eightdotz/esp32-wavplayer/src/final/README.md

Display driver changed from SSD1306 to SSD1315 and uses the ESP32-C3 chip.
