eightdotz/esp32-wavplayer/kicad_pcb_model/final/schematic.pdf

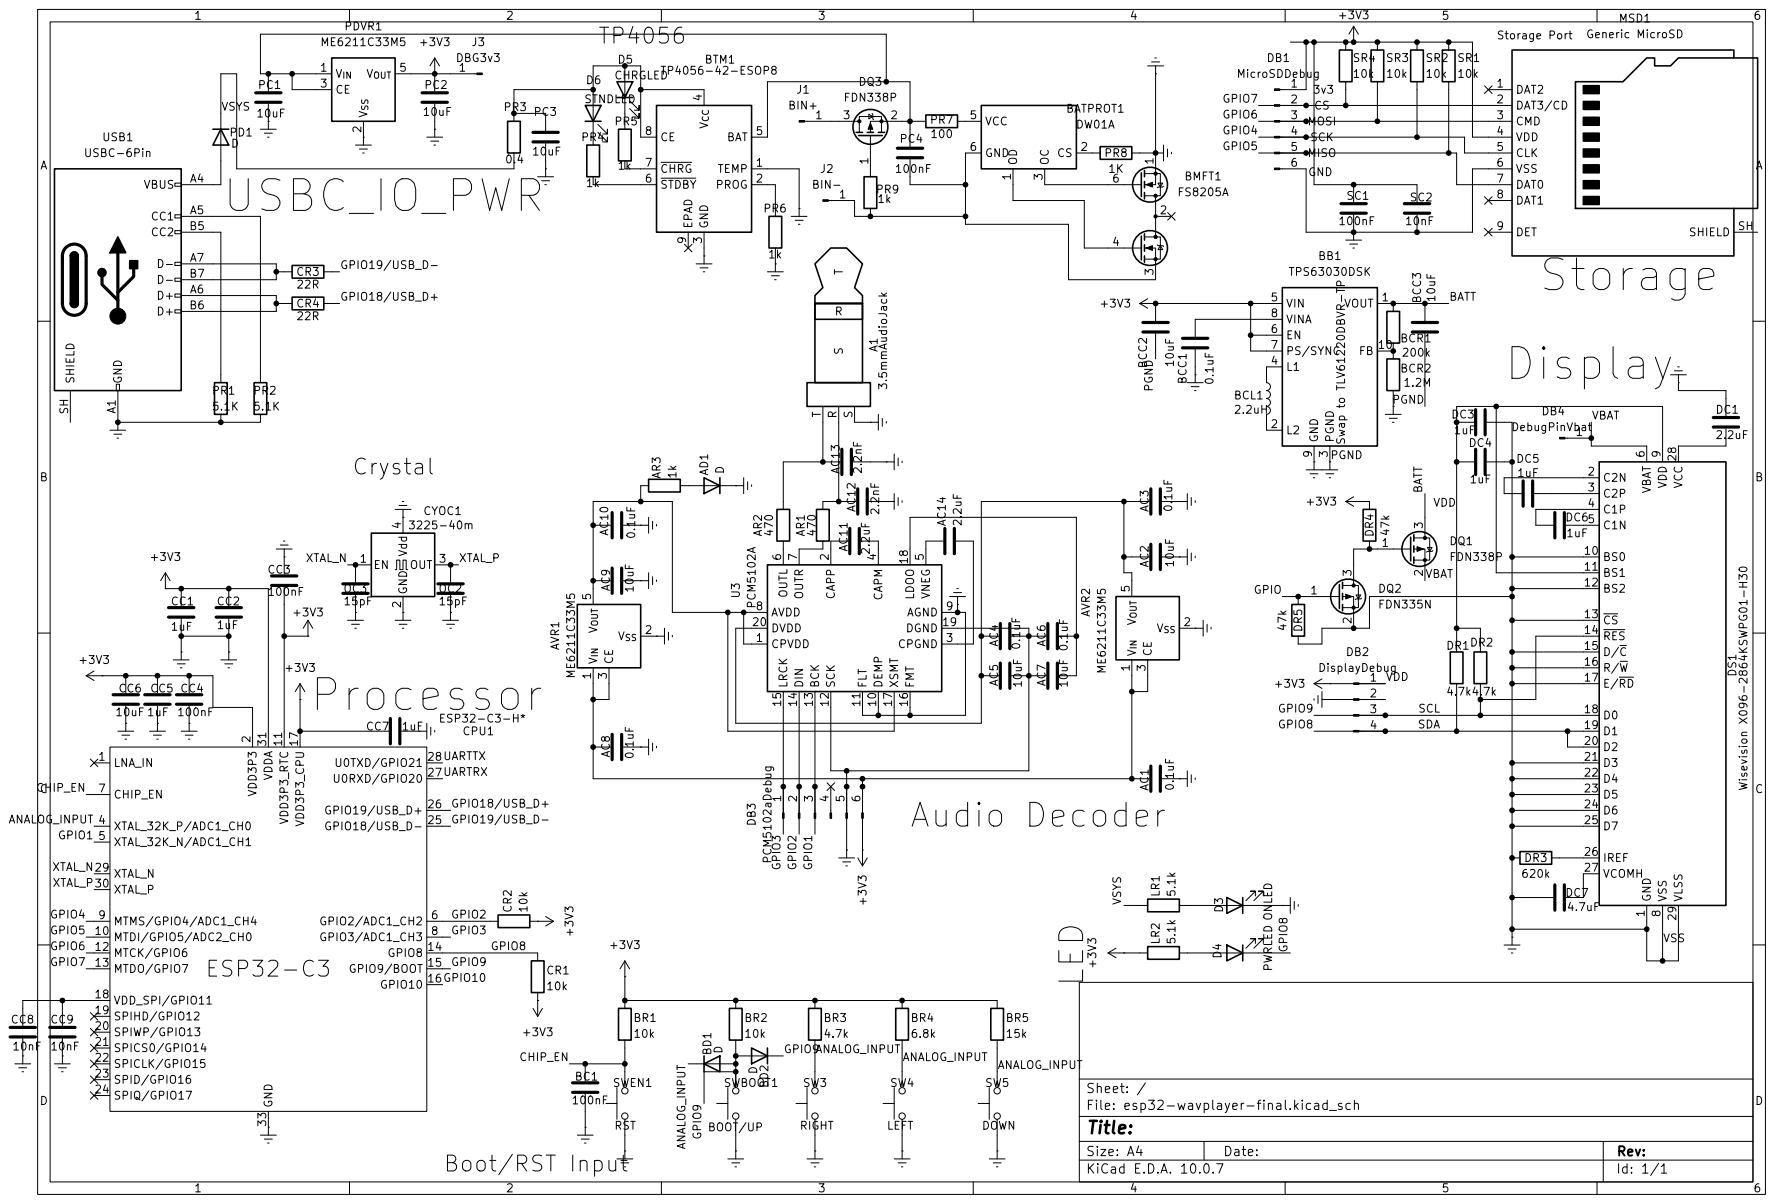
[picture p1: page 1]
