eightdotz/esp32-wavplayer/kicad_pcb_model/final/esp32-wavplayer-final.kicad_pcb

## KiCad design kicad_pcb_model/final/esp32-wavplayer-final.kicad_pcb (2026-11-09)

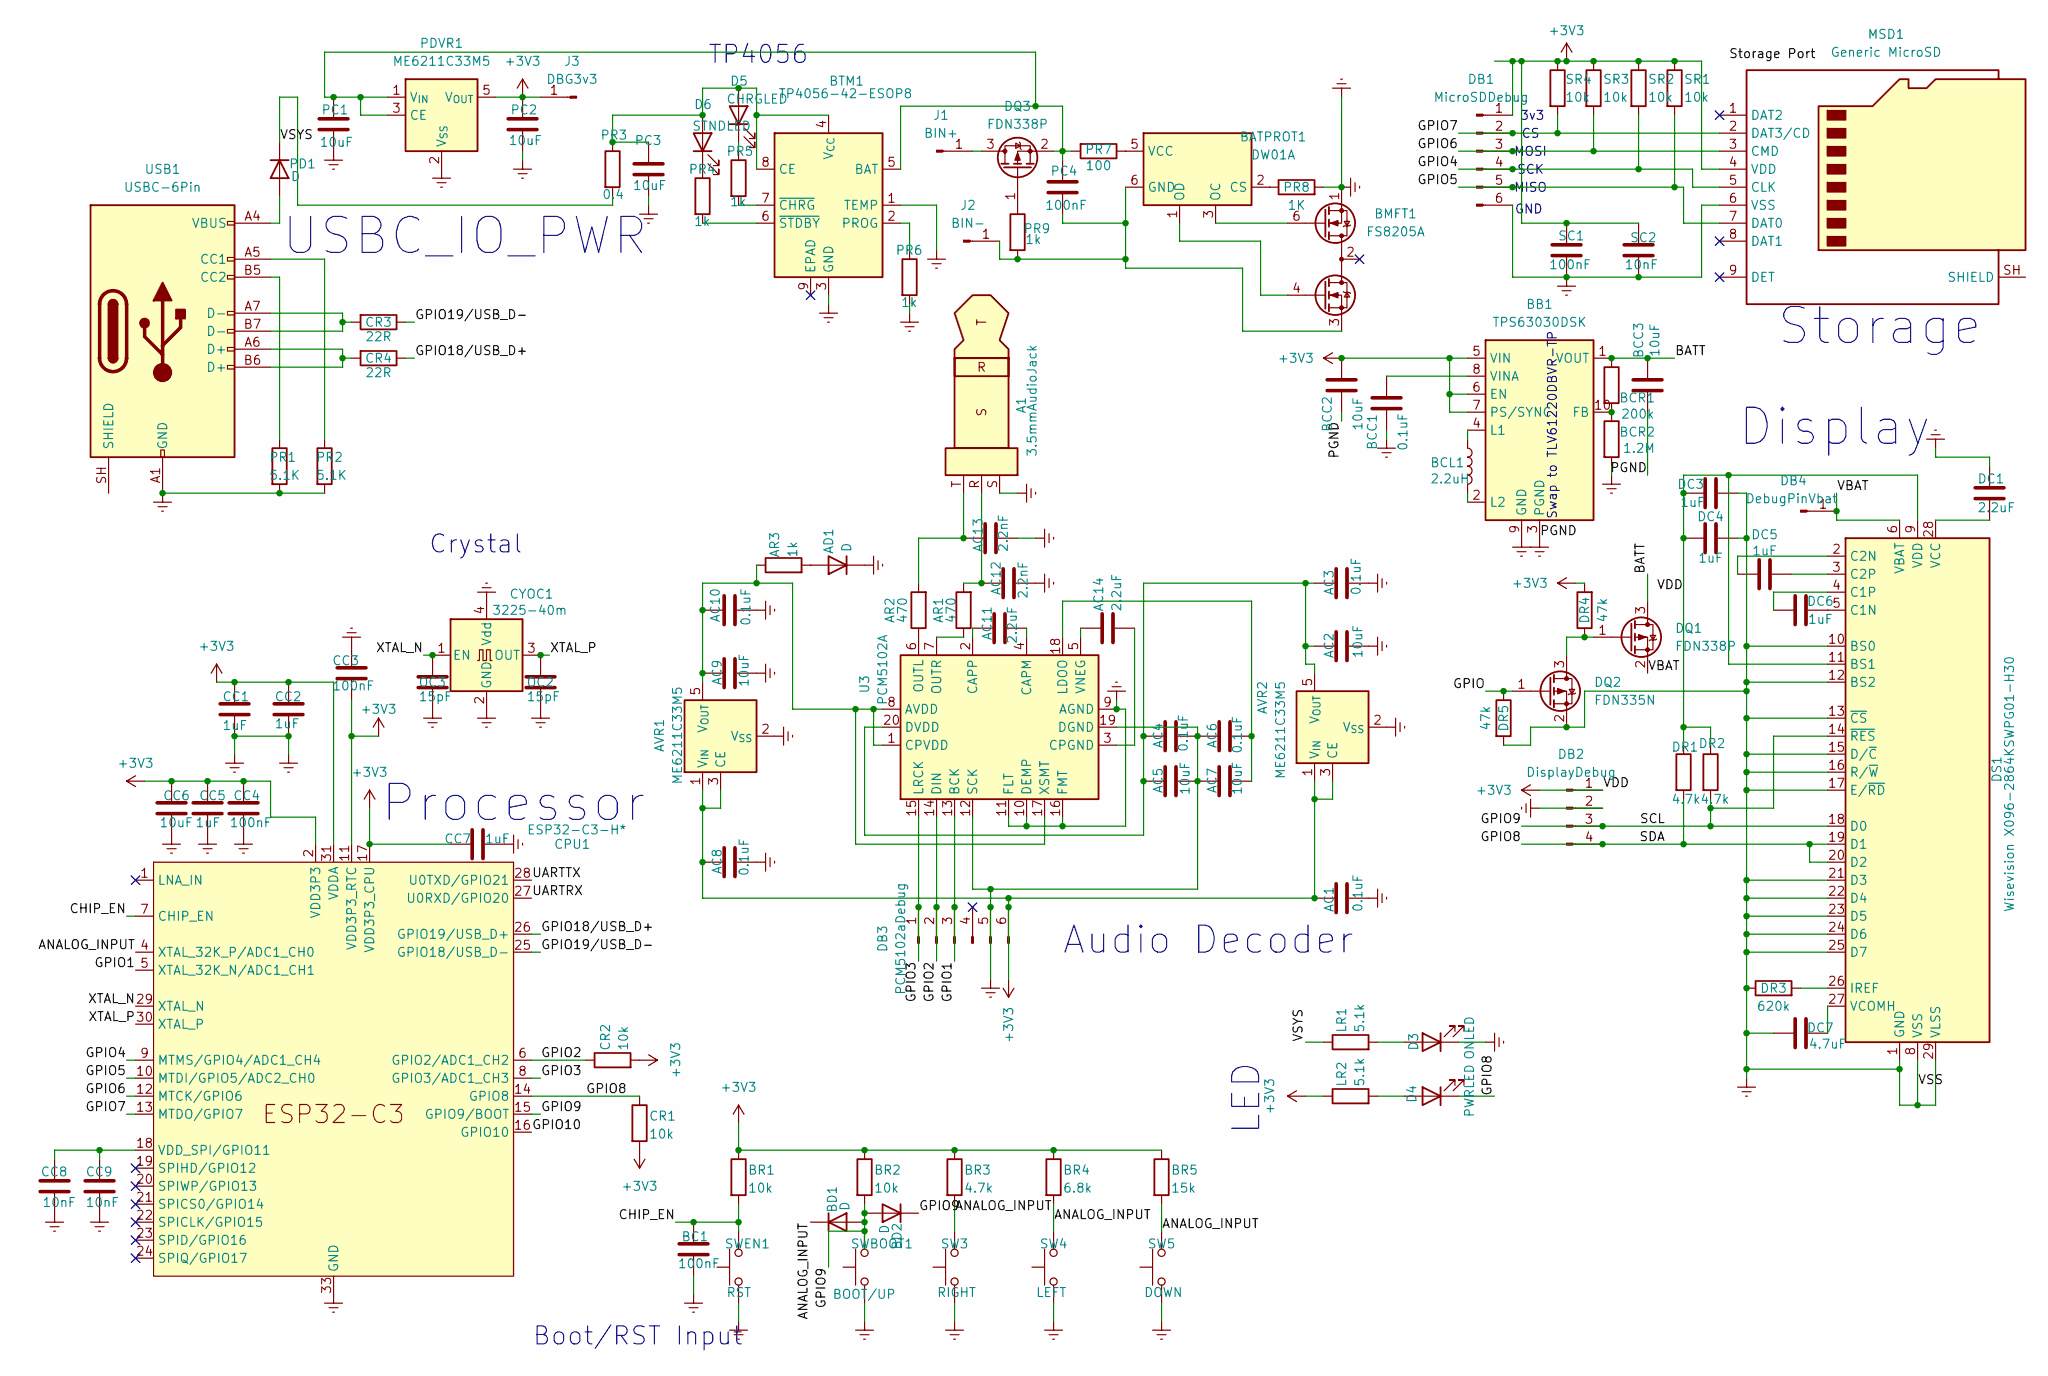
[picture p2: schematic esp32-wavplayer-final.kicad_sch]

Parts:
A1: 3.5mmAudioJack; Jack_3.5mm_KoreanHropartsElec_PJ-320D-4A_Horizontal
AC1, AC3, AC4, AC6, AC8, AC10: 0.1uF; C_0603_1608Metric_Pad1.08x0.95mm_HandSolder
AC2, AC5, AC7, AC9: 10uF; C_0603_1608Metric_Pad1.08x0.95mm_HandSolder
AC11, AC14: 2.2uF; C_0603_1608Metric_Pad1.08x0.95mm_HandSolder
AC12, AC13: 2.2nF; C_0603_1608Metric_Pad1.08x0.95mm_HandSolder
AD1: D; D_0603_1608Metric_Pad1.05x0.95mm_HandSolder
AR1, AR2: 470; R_0603_1608Metric_Pad0.98x0.95mm_HandSolder
AR3: 1k; R_0603_1608Metric_Pad0.98x0.95mm_HandSolder
AVR1, AVR2: ME6211C33M5; SOT-23-5
BATPROT1: DW01A; SOT-23-6
BB1: TPS63030DSK; WSON-10-1EP_2.5x2.5mm_P0.5mm_EP1.2x2mm
BC1: 100nF; C_0603_1608Metric_Pad1.08x0.95mm_HandSolder
BCC1: 0.1uF; C_0603_1608Metric_Pad1.08x0.95mm_HandSolder
BCC2, BCC3: 10uF; C_0603_1608Metric_Pad1.08x0.95mm_HandSolder
BCL1: 2.2uH; L_0201_0603Metric_Pad0.64x0.40mm_HandSolder
BCR1: 200k; R_0603_1608Metric_Pad0.98x0.95mm_HandSolder
BCR2: 1.2M; R_0603_1608Metric_Pad0.98x0.95mm_HandSolder
BD1, BD2: D; D_0603_1608Metric_Pad1.05x0.95mm_HandSolder
BMFT1: FS8205A; SOT-23-6
BR1, BR2: 10k; R_0603_1608Metric_Pad0.98x0.95mm_HandSolder
BR3: 4.7k; R_0603_1608Metric_Pad0.98x0.95mm_HandSolder
BR4: 6.8k; R_0603_1608Metric_Pad0.98x0.95mm_HandSolder
BR5: 15k; R_0603_1608Metric_Pad0.98x0.95mm_HandSolder
BTM1: TP4056-42-ESOP8; SOIC-8_3.9x4.9mm_P1.27mm
CC1, CC2, CC5, CC7: 1uF; C_0603_1608Metric_Pad1.08x0.95mm_HandSolder
CC3, CC4: 100nF; C_0603_1608Metric_Pad1.08x0.95mm_HandSolder
CC6: 10uF; C_0603_1608Metric_Pad1.08x0.95mm_HandSolder
CC8, CC9: 10nF; C_0603_1608Metric_Pad1.08x0.95mm_HandSolder
CPU1: ESP32-C3-H*; QFN-32-1EP_5x5mm_P0.5mm_EP3.45x3.45mm
CR1, CR2: 10k; R_0603_1608Metric_Pad0.98x0.95mm_HandSolder
CR3, CR4: 22R; R_0603_1608Metric_Pad0.98x0.95mm_HandSolder
CYOC1: 3225-40m; Oscillator_SMD_Abracon_ASE-4Pin_3.2x2.5mm
D3: PWRLED; LED_0603_1608Metric_Pad1.05x0.95mm_HandSolder
D4: ONLED; LED_0603_1608Metric_Pad1.05x0.95mm_HandSolder
D5: CHRGLED; LED_0603_1608Metric_Pad1.05x0.95mm_HandSolder
D6: STNDLED; LED_0603_1608Metric_Pad1.05x0.95mm_HandSolder
DB1: MicroSDDebug; PinHeader_1x06_P2.54mm_Vertical
DB2: DisplayDebug; PinHeader_1x04_P2.54mm_Vertical
DB3: PCM5102aDebug; PinHeader_1x06_P2.54mm_Vertical
DB4: DebugPinVbat; PinHeader_1x01_P2.54mm_Vertical
DC1: 2.2uF; C_0603_1608Metric_Pad1.08x0.95mm_HandSolder
DC3, DC4, DC5, DC6: 1uF; C_0603_1608Metric_Pad1.08x0.95mm_HandSolder
DC7: 4.7uF; C_0603_1608Metric_Pad1.08x0.95mm_HandSolder
DQ1, DQ3: FDN338P; SOT-23
DQ2: FDN335N; SOT-23
DR1, DR2: 4.7k; R_0603_1608Metric_Pad0.98x0.95mm_HandSolder
DR3: 620k; R_0603_1608Metric_Pad0.98x0.95mm_HandSolder
DR4, DR5: 47k; R_0603_1608Metric_Pad0.98x0.95mm_HandSolder
DS1: Wisevision X096-2864KSWPG01-H30; OLED-128O064D
J1: BIN+; PinHeader_1x01_P2.54mm_Vertical
J2: BIN-; PinHeader_1x01_P2.54mm_Vertical
J3: DBG3v3; PinHeader_1x01_P2.54mm_Vertical
LR1, LR2: 5.1k; R_0603_1608Metric_Pad0.98x0.95mm_HandSolder
MSD1: Generic MicroSD; microSD_HC_Hirose_DM3AT-SF-PEJM5
OC2, OC3: 15pF; C_0603_1608Metric_Pad1.08x0.95mm_HandSolder
PC1, PC2, PC3: 10uF; C_0603_1608Metric_Pad1.08x0.95mm_HandSolder
PC4: 100nF; C_0603_1608Metric_Pad1.08x0.95mm_HandSolder
PD1: D; D_0603_1608Metric_Pad1.05x0.95mm_HandSolder
PDVR1: ME6211C33M5; SOT-23-5
PR1, PR2: 5.1K; R_0603_1608Metric_Pad0.98x0.95mm_HandSolder
PR3: 0.4; R_0603_1608Metric_Pad0.98x0.95mm_HandSolder
PR4, PR5, PR6, PR9: 1k; R_0603_1608Metric_Pad0.98x0.95mm_HandSolder
PR7: 100; R_0603_1608Metric_Pad0.98x0.95mm_HandSolder
PR8: 1K; R_0603_1608Metric_Pad0.98x0.95mm_HandSolder
SC1: 100nF; C_0603_1608Metric_Pad1.08x0.95mm_HandSolder
SC2: 10nF; C_0603_1608Metric_Pad1.08x0.95mm_HandSolder
SR1, SR2, SR3, SR4: 10k; R_0603_1608Metric_Pad0.98x0.95mm_HandSolder
SW3: RIGHT; SW_SPST_TS-1088-xR020
SW4: LEFT; SW_SPST_TS-1088-xR020
SW5: DOWN; SW_SPST_TS-1088-xR020
SWBOOT1: BOOT/UP; SW_SPST_TS-1088-xR020
SWEN1: RST; SW_SPST_TS-1088-xR020
U3: PCM5102A; TSSOP-20_4.4x6.5mm_P0.65mm
USB1: USBC-6Pin; USB_C_Receptacle_HRO_TYPE-C-31-M-12

Connections:
+3V3: AC1.1, AC8.1, AVR1.1 (V_{IN}), AVR1.3 (CE), AVR2.1 (V_{IN}), AVR2.3 (CE), BB1.5 (VIN), BB1.6 (EN), BB1.7 (PS/SYNC), BCC2.2, BR1.1, BR2.1, BR3.1, BR4.1, BR5.1, CC1.1, CC2.1, CC3.2, CC4.1, CC5.1, CC6.1, CC7.1, CPU1.2 (VDD3P3), CPU1.3 (VDD3P3), CPU1.11 (VDD3P3_RTC), CPU1.17 (VDD3P3_CPU), CPU1.31 (VDDA), CPU1.32 (VDDA), CR1.2, CR2.2, DB1.1, DB2.1, DB3.6, DC3.1, DC4.2, DR1.1, DR2.1, DR4.2, DS1.9 (VDD), DS1.11 (BS1), J3.1 (Pin_1_1), LR2.1, MSD1.4 (VDD), PC2.1, PDVR1.5 (V_{OUT}), SC1.1, SC2.1, SR1.1, SR2.1, SR3.1, SR4.1
/ANALOG_INPUT: BD1.1 (K), BR3.2, BR4.2, BR5.2, CPU1.4 (XTAL_32K_P/ADC1_CH0), SW3.2, SW4.2, SW5.2
/BATT: BB1.1 (VOUT), BCC3.2, BCR1.1, DQ1.3 (D)
/CHIP_EN: BC1.1, BR1.2, CPU1.7 (CHIP_EN), SWEN1.2
/GPIO: DQ2.1 (G), DR5.1
/GPIO1: CPU1.5 (XTAL_32K_N/ADC1_CH1), DB3.3, U3.13 (BCK)
/GPIO2: CPU1.6 (GPIO2/ADC1_CH2), CR2.1, DB3.2, U3.14 (DIN)
/GPIO3: CPU1.8 (GPIO3/ADC1_CH3), DB3.1, U3.15 (LRCK)
/GPIO4: CPU1.9 (MTMS/GPIO4/ADC1_CH4), DB1.4, MSD1.5 (CLK), SR2.2
/GPIO5: CPU1.10 (MTDI/GPIO5/ADC2_CH0), DB1.5, MSD1.7 (DAT0), SR1.2
/GPIO6: CPU1.12 (MTCK/GPIO6), DB1.3, MSD1.3 (CMD), SR3.2
/GPIO7: CPU1.13 (MTDO/GPIO7), DB1.2, MSD1.2 (DAT3/CD), SR4.2
/GPIO8: CPU1.14 (GPIO8), CR1.1, D4.1 (K), DB2.4, DR1.2, DS1.19 (D1), DS1.20 (D2)
/GPIO9: BD1.2 (A), BD2.1 (K), BD2.2 (A), BR2.2, CPU1.15 (GPIO9/BOOT), DB2.3, DR2.2, DS1.14 (~RES), DS1.18 (D0), SWBOOT1.2
/GPIO10: CPU1.16 (GPIO10)
/GPIO18/USB_D+: CPU1.26 (GPIO19/USB_D+), CR4.1
/GPIO19/USB_D-: CPU1.25 (GPIO18/USB_D-), CR3.1
/UARTRX: CPU1.27 (U0RXD/GPIO20)
/UARTTX: CPU1.28 (U0TXD/GPIO21)
/VBAT: DB4.1 (Pin_1_1), DQ1.2 (S), DS1.6 (VBAT)
/VSYS: LR1.1, PD1.1 (K), PR3.2
/XTAL_N: CPU1.29 (XTAL_N), CYOC1.1 (EN), OC3.1
/XTAL_P: CPU1.30 (XTAL_P), CYOC1.3 (OUT), OC2.1
Earth: A1.S, AC1.2, AC2.2, AC3.2, AC4.2, AC5.2, AC6.1, AC7.1, AC8.2, AC9.2, AC10.2, AC12.2, AC13.2, AD1.1 (K), AVR1.2 (V_{SS}), AVR2.2 (V_{SS}), BB1.3 (PGND), BB1.9 (GND), BB1.11 (PGND), BC1.2, BCC1.1, BCC2.1, BCC3.1, BCR2.2, BMFT1.1 (D1), BTM1.1 (TEMP), BTM1.3 (GND), CC1.2, CC2.2, CC3.1, CC4.2, CC5.2, CC6.2, CC7.2, CC8.2, CC9.2, CPU1.33 (GND), CYOC1.2 (GND), CYOC1.4 (Vdd), D3.1 (K), DB1.6, DB2.2, DB3.5, DC1.1, DC3.2, DC4.1, DC7.1, DQ2.2 (S), DR3.1, DR5.2, DS1.1 (GND), DS1.8 (VSS), DS1.10 (BS0), DS1.12 (BS2), DS1.13 (~CS), DS1.15 (D/~C), DS1.16 (R/~W), DS1.17 (E/~RD), DS1.21 (D3), DS1.22 (D4), DS1.23 (D5), DS1.24 (D6), DS1.25 (D7), DS1.29 (VLSS), DS1.30 (GND), MSD1.6 (VSS), OC2.2, OC3.2, PC1.2, PC2.2, PC3.2, PDVR1.2 (V_{SS}), PR1.2, PR2.2, PR6.2, PR8.2, SC1.2, SC2.2, SW3.1, SW4.1, SW5.1, SWBOOT1.1, SWEN1.1, U3.9 (AGND), U3.10 (DEMP), U3.11 (FLT), U3.12 (SCK), U3.16 (FMT), U3.19 (DGND), USB1.A1 (GND), USB1.A12 (GND), USB1.B1 (GND), USB1.B12 (GND)
unnamed: A1.R, AC12.1, AR1.2
unnamed: A1.T, AC13.1, AR2.2
unnamed: AD1.2 (A), AR3.2
unnamed: AC9.1, AC10.1, AR3.1, AVR1.5 (V_{OUT}), U3.1 (CPVDD), U3.8 (AVDD), U3.17 (XSMT)
unnamed: AC2.1, AC3.1, AC4.1, AC5.1, AVR2.5 (V_{OUT}), U3.20 (DVDD)
unnamed: BATPROT1.2 (CS), PR8.1
unnamed 30: BATPROT1.6 (GND), BMFT1.3 (S2), J2.1, PC4.2, PR9.2; also elsewhere on the board
unnamed: BATPROT1.3 (OC), BMFT1.6 (G1)
unnamed: BATPROT1.1 (OD), BMFT1.4 (G2)
unnamed: BATPROT1.5 (VCC), PR7.1
unnamed: BB1.10 (FB), BCR1.2, BCR2.1
unnamed: BB1.4 (L1), BCL1.1
unnamed: BB1.2 (L2), BCL1.2
unnamed: BB1.8 (VINA), BCC1.2
unnamed: BTM1.5 (BAT), DQ3.2 (S), PC1.1, PC4.1, PDVR1.1 (V_{IN}), PDVR1.3 (CE), PR7.2
unnamed: BTM1.4 (V_{CC}), BTM1.8 (CE), D5.2 (A), D6.2 (A), PC3.1, PR3.1
unnamed: BTM1.2 (PROG), PR6.1
unnamed: BTM1.7 (~CHRG), PR5.2
unnamed: BTM1.6 (~STDBY), PR4.2
unnamed: CC8.1, CC9.1, CPU1.18 (VDD_SPI/GPIO11)
unnamed: CR3.2, USB1.A7 (D-), USB1.B7 (D-)
unnamed: CR4.2, USB1.A6 (D+), USB1.B6 (D+)
unnamed: D3.2 (A), LR1.2
unnamed: D4.2 (A), LR2.2
unnamed: D5.1 (K), PR5.1
unnamed: D6.1 (K), PR4.1
unnamed: DQ1.1 (G), DQ2.3 (D), DR4.1
unnamed: DQ3.3 (D), J1.1 (Pin_1_1)
unnamed: DQ3.1 (G), PR9.1
unnamed: DC6.2, DS1.5 (C1N)
unnamed: DC6.1, DS1.4 (C1P)
unnamed: DC5.1, DS1.2 (C2N)
unnamed: DC5.2, DS1.3 (C2P)
unnamed: DR3.2, DS1.26 (IREF)
unnamed: DC1.2, DS1.28 (VCC)
unnamed: DC7.2, DS1.27 (VCOMH)
unnamed: PD1.2 (A), USB1.A4 (VBUS), USB1.A9 (VBUS), USB1.B4 (VBUS), USB1.B9 (VBUS)
unnamed: AC11.2, U3.4 (CAPM)
unnamed: AC11.1, U3.2 (CAPP)
unnamed: AC14.2, U3.3 (CPGND)
unnamed: AC6.2, AC7.2, U3.18 (LDOO)
unnamed: AR2.1, U3.6 (OUTL)
unnamed: AR1.1, U3.7 (OUTR)
unnamed: AC14.1, U3.5 (VNEG)
unnamed: PR2.1, USB1.A5 (CC1)
unnamed: PR1.1, USB1.B5 (CC2)

Notes on the sheet:
Display
Storage
Audio Decoder
MOSI
MISO
Crystal
LED
SCK
Processor
USBC_IO_PWR
3v3
GND
TP4056
Boot/RST Input
Swap to TLV61220DBVR-TP

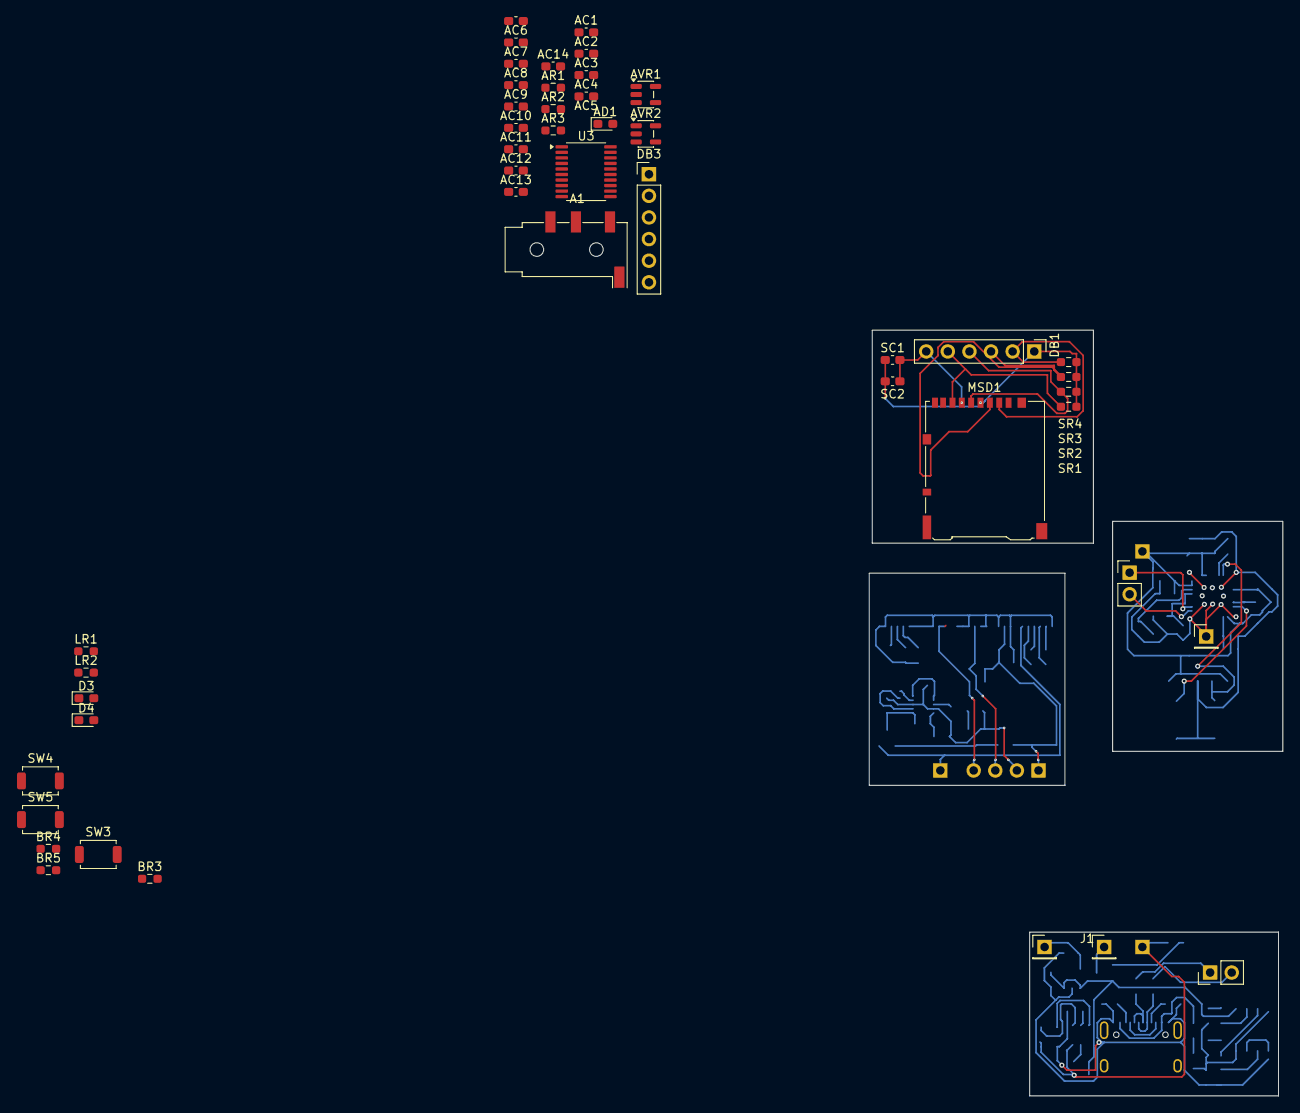
[picture p3: board esp32-wavplayer-final.kicad_pcb from above]

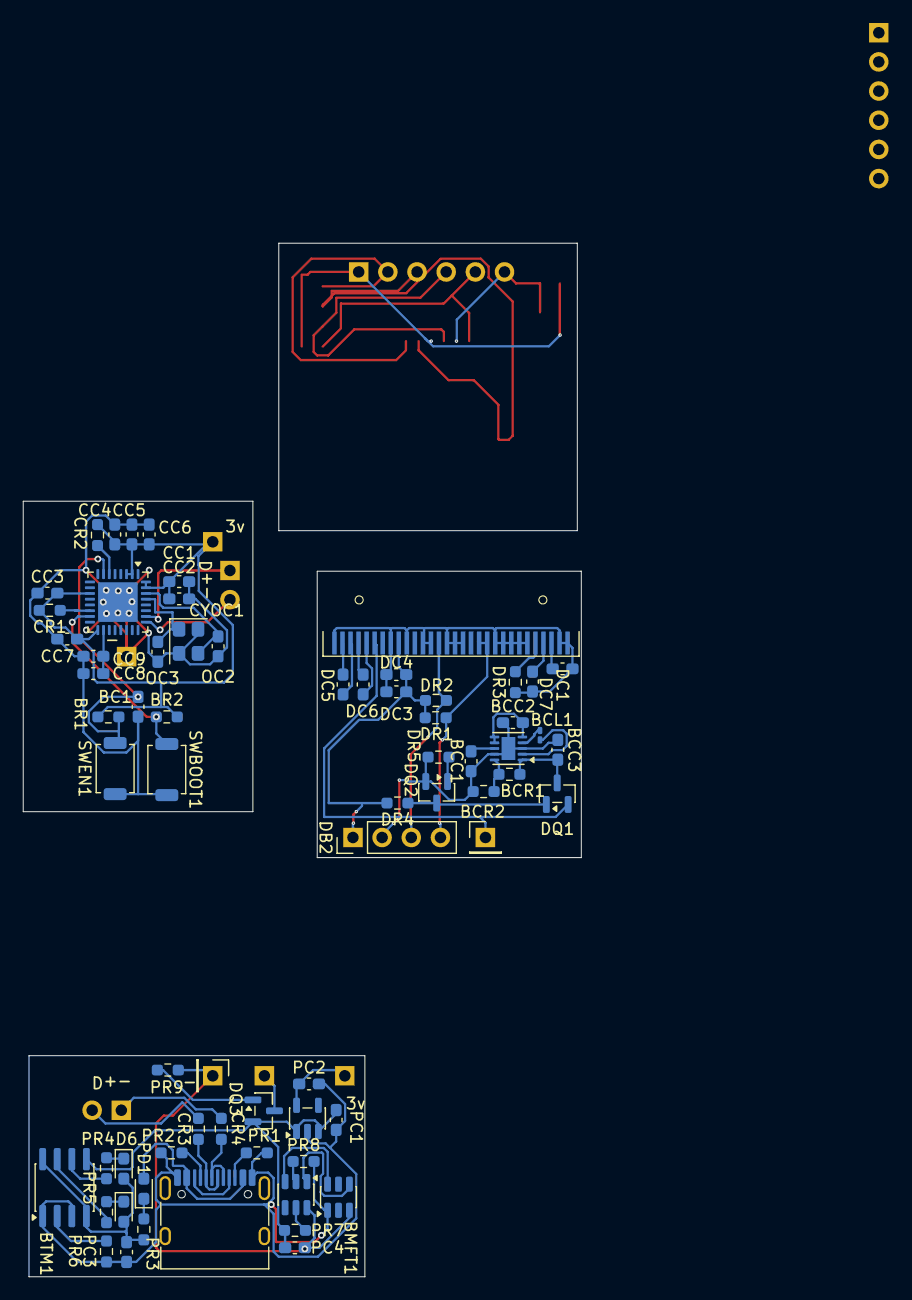
[picture p4: board esp32-wavplayer-final.kicad_pcb from below]

Board: 2 copper layers, 48.6 x 90.0 mm, 111 parts (68 on the bottom side), 67 nets.

Other parts of the board:
-: BIN-; PinHeader_1x01_P2.54mm_Vertical

Their connections:
unnamed 30: -.1 (Pin_1_1); also elsewhere on the board
