eightdotz/esp32-wavplayer/kicad_pcb_model/demo/wavplayer-1_2.kicad_pcb

## KiCad design kicad_pcb_model/demo/wavplayer-1_2.kicad_pcb (2026-09-13)

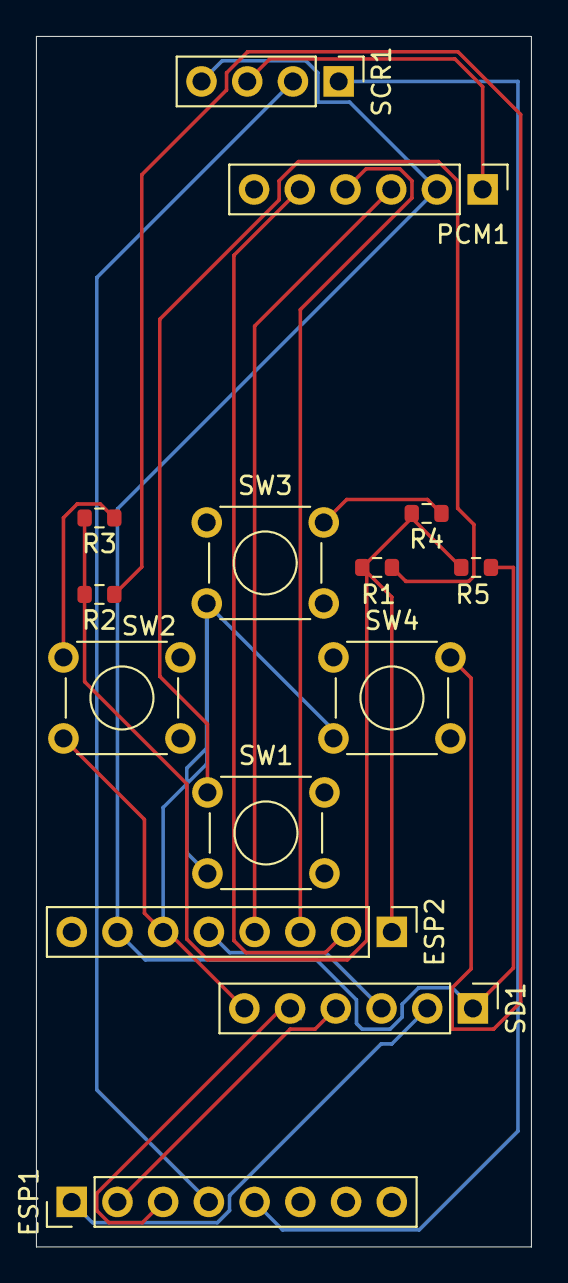
[picture p5: board wavplayer-1_2.kicad_pcb from above]

Board: 2 copper layers, 27.5 x 67.2 mm, 14 parts (0 on the bottom side), 16 nets.

Parts:
ESP1: ESP32_C3_SuperMini_Right; PinHeader_1x08_P2.54mm_Vertical
ESP2: ESP32_C3_SuperMini_Left; PinHeader_1x08_P2.54mm_Vertical
PCM1: PCM5102a_Genaric; PinHeader_1x06_P2.54mm_Vertical
R1: 1.5k; R_0603_1608Metric
R2: 5.1k; R_0603_1608Metric
R3: 6.8k; R_0603_1608Metric
R4, R5: 10k; R_0603_1608Metric
SCR1: SSD1306; PinHeader_1x04_P2.54mm_Vertical
SD1: SDcard_Generic; PinHeader_1x06_P2.54mm_Vertical
SW1: DOWN; SW_TH_Tactile_Omron_B3F-100x
SW2: BACK; SW_TH_Tactile_Omron_B3F-100x
SW3: UP; SW_TH_Tactile_Omron_B3F-100x
SW4: ENTER; SW_TH_Tactile_Omron_B3F-100x

Connections:
+3V3: ESP2.6, PCM1.1, SCR1.3, SD1.6, SW1.2, SW2.2, SW3.2, SW4.2
/CS: ESP1.3, SD1.5
/GP0_ADC1_0: ESP2.1, R1.2, R2.2, R3.2, R4.2, R5.2
/GP1_ADC1_1: ESP2.2, PCM1.5
/GP2_ADC1_2: ESP2.3, PCM1.4
/GP3_ADC1_3: ESP2.4, PCM1.3
/MISO: ESP1.1, SD1.2
/MOSI: ESP1.2, SD1.4
/SCK: ESP2.5, SD1.3
/SCL: ESP1.4, SCR1.2
/SDA: ESP1.5, SCR1.1
GND: ESP2.7, PCM1.2, R5.1, SCR1.4, SD1.1
unnamed: R1.1, SW1.1
unnamed: R2.1, SW4.1
unnamed: R3.1, SW2.1
unnamed: R4.1, SW3.1
