eightdotz/esp32-wavplayer/(commit log)

2026-09-13 Organizing, preparing final pcb
    [esp32-wavplayer-final.kicad_pcb, esp32-wavplayer-final.kicad_sch, wavplayer-1_0.kicad_pcb, wavplayer-1_0.kicad_sch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]
2026-09-14 Creating schematic
    [esp32-wavplayer-final.kicad_sch]
2026-09-14 Audio hookup
    [esp32-wavplayer-final.kicad_sch]
2026-09-14 Organizing Schematic
    [esp32-wavplayer-final.kicad_sch]
2026-09-15 Added crystal, input, and leds
    [esp32-wavplayer-final.kicad_sch]
2026-09-16 Added tp4096
    [esp32-wavplayer-final.kicad_sch]
2026-09-16 Adding battery circuit and updating pcb
    [esp32-wavplayer-final.kicad_pcb, esp32-wavplayer-final.kicad_sch]
2026-09-27 Routing PCB
    [esp32-wavplayer-final.kicad_pcb, esp32-wavplayer-final.kicad_sch]
2026-09-28 Powerstage redesign
    [esp32-wavplayer-final.kicad_pcb, esp32-wavplayer-final.kicad_sch]
2026-09-28 Routing input and display
    [esp32-wavplayer-final.kicad_pcb]
2026-10-05 Fixing shiz
    [esp32-wavplayer-final.kicad_pcb, esp32-wavplayer-final.kicad_sch]
2026-10-05 updated wisevision configuration
    [esp32-wavplayer-final.kicad_pcb, esp32-wavplayer-final.kicad_sch]
2026-10-05 updating model
    [esp32-wavplayer-final.kicad_pcb, esp32-wavplayer-final.kicad_sch]
2026-10-05 fixed battery connection
    [esp32-wavplayer-final.kicad_pcb, esp32-wavplayer-final.kicad_sch]
2026-10-06 Added CPU board
    [esp32-wavplayer-final.kicad_pcb]
2026-10-07 finished screen, added sdcard
    [esp32-wavplayer-final.kicad_pcb]
2026-10-10 Generating debug files
    [esp32-wavplayer-final-B_Cu.gbr, esp32-wavplayer-final-B_Mask.gbr, esp32-wavplayer-final-B_Paste.gbr, esp32-wavplayer-final-B_Silkscreen.gbr, esp32-wavplayer-final-Edge_Cuts.gbr, esp32-wavplayer-final-F_Cu.gbr, esp32-wavplayer-final-F_Mask.gbr, esp32-wavplayer-final-F_Paste.gbr]
2026-10-17 Switched to RTOS Semaphore based audio management
2026-10-29 folder for arduinoide
2026-11-06 updated schematic
2026-11-09 cpu en boot buttons
